rudiiz64/yunaboard/yunaboard/yunaboard.kicad_pcb

## KiCad design yunaboard/yunaboard.kicad_pcb (2026-02-03)

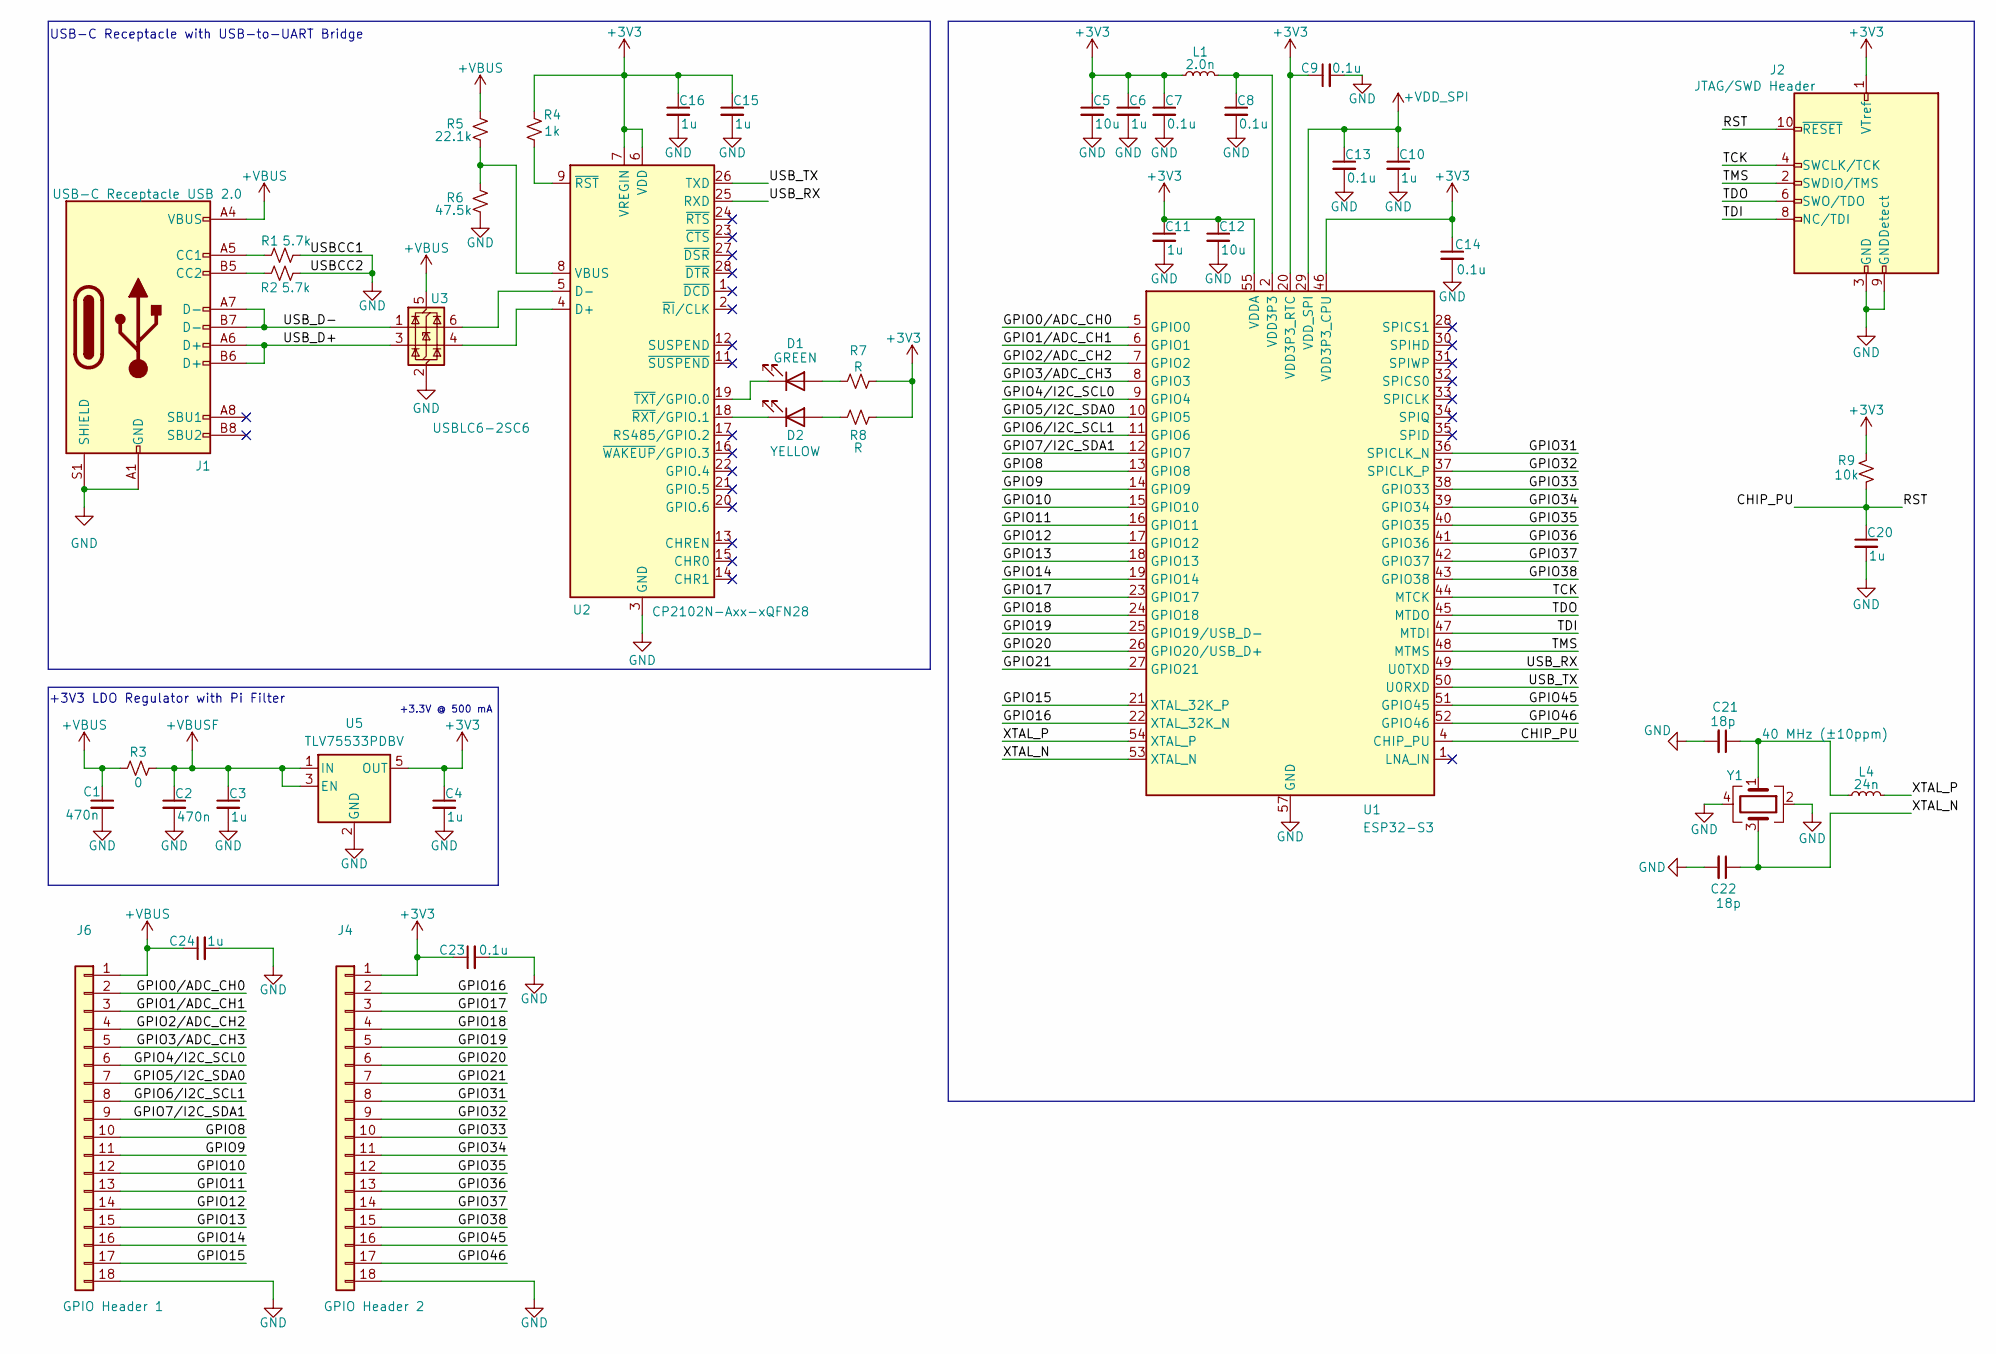
[picture p1: schematic yunaboard.kicad_sch]

Parts:
C1, C2: 470n; C_0603_1608Metric
C3, C4, C6, C10, C11, C15, C16, C20: 1u; C_0603_1608Metric
C5, C12: 10u; C_0603_1608Metric
C7, C8, C9, C13, C14, C23: 0.1u; C_0402_1005Metric
C21, C22: 18p; C_0402_1005Metric
C24: 1u; C_0402_1005Metric
D1: GREEN; LED_0603_1608Metric
D2: YELLOW; LED_0603_1608Metric
J1: USB-C Receptacle USB 2.0; USB_C_Receptacle_GCT_USB4105-xx-A_16P_TopMnt_Horizontal
J2: JTAG/SWD Header; PinHeader_2x06_P1.27mm_Vertical
J4: GPIO Header 2; PinHeader_1x18_P2.00mm_Vertical
J6: GPIO Header 1; PinHeader_1x18_P2.00mm_Vertical
L1: 2.0n; L_0201_0603Metric
L4: 24n; L_0201_0603Metric
R1, R2: 5.7k; R_0603_1608Metric
R3: 0; R_0402_1005Metric
R4: 1k; R_0402_1005Metric
R5: 22.1k; R_0402_1005Metric
R6: 47.5k; R_0402_1005Metric
R7, R8: R; R_0402_1005Metric
R9: 10k; R_0402_1005Metric
U1: ESP32-S3; QFN-56-1EP_7x7mm_P0.4mm_EP4x4mm
U2: CP2102N-Axx-xQFN28; QFN-28-1EP_5x5mm_P0.5mm_EP3.35x3.35mm
U3: USBLC6-2SC6; SOT-23-6
U5: TLV75533PDBV; SOT-23-5
Y1: 40 MHz (±10ppm); Crystal_SMD_3225-4Pin_3.2x2.5mm

Connections:
+3V3: C4.1, C5.1, C6.1, C7.1, C9.1, C11.1, C12.1, C14.1, C15.1, C16.1, C23.1, J2.1 (VTref), J4.1, L1.1, R4.1, R7.2, R8.2, R9.2, U1.20 (VDD3P3_RTC), U1.46 (VDD3P3_CPU), U1.55 (VDDA), U1.56 (VDDA), U2.6 (VDD), U2.7 (VREGIN), U5.5 (OUT)
+VBUS: C1.1, C24.1, J1.A4 (VBUS), J1.A9 (VBUS), J1.B4 (VBUS), J1.B9 (VBUS), J6.1, R3.2, R5.1, U3.5 (VBUS)
+VBUSF: C2.1, C3.1, R3.1, U5.1 (IN), U5.3 (EN)
+VDD_SPI: C10.1, C13.1, U1.29 (VDD_SPI)
/CHIP_PU: C20.1, J2.10 (~RESET), R9.1, U1.4 (CHIP_PU)
/GPIO0/ADC_CH0: J6.2, U1.5 (GPIO0)
/GPIO1/ADC_CH1: J6.3, U1.6 (GPIO1)
/GPIO2/ADC_CH2: J6.4, U1.7 (GPIO2)
/GPIO3/ADC_CH3: J6.5, U1.8 (GPIO3)
/GPIO4/I2C_SCL0: J6.6, U1.9 (GPIO4)
/GPIO5/I2C_SDA0: J6.7, U1.10 (GPIO5)
/GPIO6/I2C_SCL1: J6.8, U1.11 (GPIO6)
/GPIO7/I2C_SDA1: J6.9, U1.12 (GPIO7)
/GPIO8: J6.10, U1.13 (GPIO8)
/GPIO9: J6.11, U1.14 (GPIO9)
/GPIO10: J6.12, U1.15 (GPIO10)
/GPIO11: J6.13, U1.16 (GPIO11)
/GPIO12: J6.14, U1.17 (GPIO12)
/GPIO13: J6.15, U1.18 (GPIO13)
/GPIO14: J6.16, U1.19 (GPIO14)
/GPIO15: J6.17, U1.21 (XTAL_32K_P)
/GPIO16: J4.2, U1.22 (XTAL_32K_N)
/GPIO17: J4.3, U1.23 (GPIO17)
/GPIO18: J4.4, U1.24 (GPIO18)
/GPIO19: J4.5, U1.25 (GPIO19/USB_D-)
/GPIO20: J4.6, U1.26 (GPIO20/USB_D+)
/GPIO21: J4.7, U1.27 (GPIO21)
/GPIO31: J4.8, U1.36 (SPICLK_N)
/GPIO32: J4.9, U1.37 (SPICLK_P)
/GPIO33: J4.10, U1.38 (GPIO33)
/GPIO34: J4.11, U1.39 (GPIO34)
/GPIO35: J4.12, U1.40 (GPIO35)
/GPIO36: J4.13, U1.41 (GPIO36)
/GPIO37: J4.14, U1.42 (GPIO37)
/GPIO38: J4.15, U1.43 (GPIO38)
/GPIO45: J4.16, U1.51 (GPIO45)
/GPIO46: J4.17, U1.52 (GPIO46)
/TCK: J2.4 (SWCLK/TCK), U1.44 (MTCK)
/TDI: J2.8 (NC/TDI), U1.47 (MTDI)
/TDO: J2.6 (SWO/TDO), U1.45 (MTDO)
/TMS: J2.2 (SWDIO/TMS), U1.48 (MTMS)
/USB_D+: J1.A6 (D+), J1.B6 (D+), U3.3 (I/O2)
/USB_D-: J1.A7 (D-), J1.B7 (D-), U3.1 (I/O1)
/USB_RX: U1.49 (U0TXD), U2.25 (RXD)
/USB_TX: U1.50 (U0RXD), U2.26 (TXD)
/XTAL_N: C22.1, U1.53 (XTAL_N), Y1.3
/XTAL_P: L4.2, U1.54 (XTAL_P)
GND: C1.2, C2.2, C3.2, C4.2, C5.2, C6.2, C7.2, C8.2, C9.2, C10.2, C11.2, C12.2, C13.2, C14.2, C15.2, C16.2, C20.2, C21.2, C22.2, C23.2, C24.2, J1.A1 (GND), J1.A12 (GND), J1.B1 (GND), J1.B12 (GND), J1.S1 (SHIELD), J2.3 (GND), J2.5 (GND), J2.9 (GNDDetect), J4.18, J6.18, R1.1, R2.1, R6.2, U1.57 (GND), U2.3 (GND), U2.29 (GND), U3.2 (GND), U5.2 (GND), Y1.2, Y1.4
unnamed: C8.1, L1.2, U1.2 (VDD3P3), U1.3 (VDD3P3)
unnamed: C21.1, L4.1, Y1.1
unnamed: D1.2 (A), R7.1
unnamed: D1.1 (K), U2.19 (~TXT/GPIO.0)
unnamed: D2.2 (A), R8.1
unnamed: D2.1 (K), U2.18 (~RXT/GPIO.1)
unnamed: J1.A5 (CC1), R1.2
unnamed: J1.B5 (CC2), R2.2
unnamed: U2.4 (D+), U3.4 (I/O2)
unnamed: U2.5 (D-), U3.6 (I/O1)
unnamed: R5.2, R6.1, U2.8 (VBUS)
unnamed: R4.2, U2.9 (~RST)

Notes on the sheet:
+3V3 LDO Regulator with Pi Filter
USB-C Receptacle with USB-to-UART Bridge
+3.3V @ 500 mA

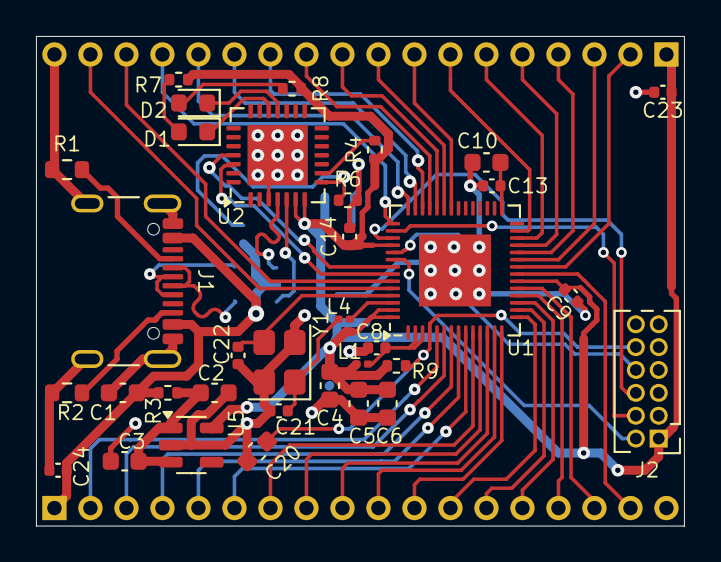
[picture p2: board yunaboard.kicad_pcb from above]

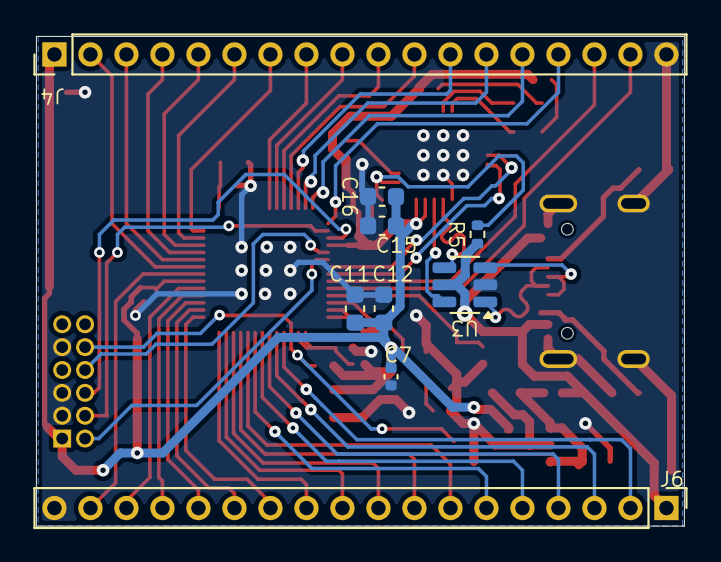
[picture p3: board yunaboard.kicad_pcb from below]

Board: 2 copper layers, 36.0 x 27.2 mm, 43 parts (9 on the bottom side), 60 nets.
