rudiiz64/yunaboard/(commit log)

2026-01-22 Rev 0.1
    - Created repo
    - Created project
    - Initial microcontroller ESP32-S3 placed
    - Initial USB-C Receptacle for 2.0 placed
    - Initial documentation for ESP32 and USB-C saved
    [yunaboard.kicad_pcb, yunaboard.kicad_sch]
2026-01-22 Rev 0.1
    - Added initial USB-C connections
    - Added ESD to USB-C data signals
    - Added initial USB-to-UART bridge IC
    - Added initial bulk capacitors to power inputs
    - Added initial +3.3V LDO regulator
    - Added initial ESP32 S3 circuitry
    [yunaboard.kicad_sch]
2026-01-26 Updated schematic
    - Placed JTAG tag connect
    - Placed initial circuitry to the ESP32 S3 (RF, chip PU)
    - Added some labels for better readability
    - Found some more documentation for the ESP32
    - Added some LEDs to the USB-to-UART bridge
    [yunaboard.kicad_sch]
2026-01-27 Updated
    - Added footprints to every component
    - Selected capacitors for the external crystals (TBT)
    [yunaboard.kicad_sch]
2026-01-28 Update
    - Added GPIO pin headers
    - Excluded RF antenna portion (LNA_IN) - may add in the future
    - Started initial PCB layout
    [yunaboard.kicad_pcb, yunaboard.kicad_sch]
2026-02-02 Update
    - Changed JTAG connector to pin header for SWD
    - Changed GPIO pin headers from 1mm length to 2mm length
    - Adjusted the layout of the PCB from the initial design
    [yunaboard.kicad_pcb, yunaboard.kicad_sch]
2026-02-03 Finalzed PCB
    - Changed LDO to TLV75533PDBVR for an output current of 500 mA
    - Adjusted some routing to reduce ground plane breaking
    - Adjusted some 3V3 traces to be 0.5mm instead of 0.3mm
    [yunaboard.kicad_pcb, yunaboard.kicad_sch]
